peterashwoodsmith/vcheck/vcheck.pdf

+5v

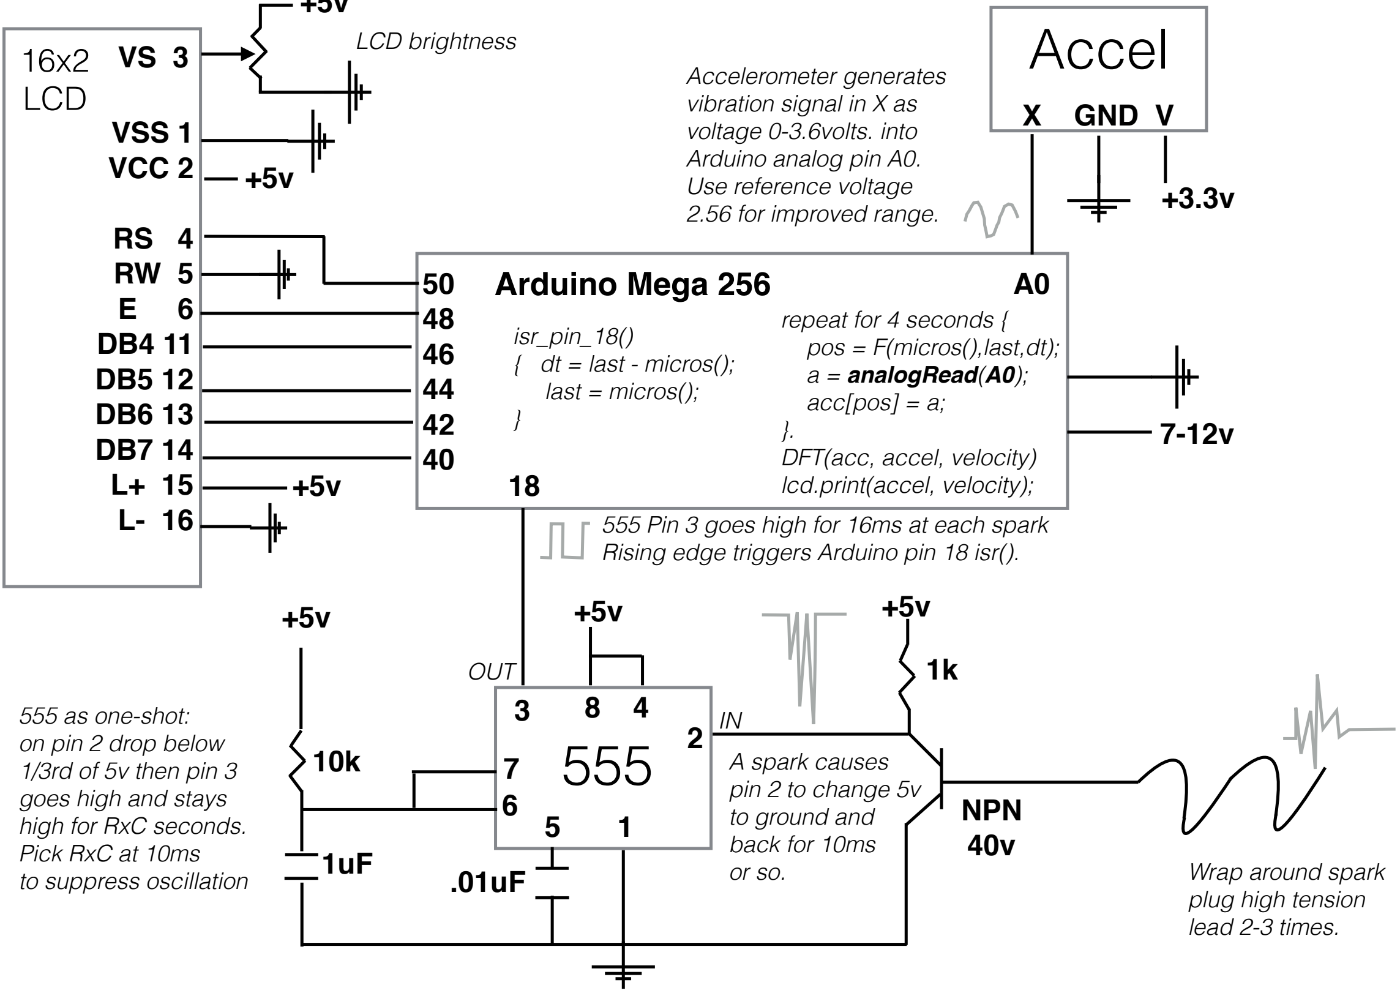
[picture p1: figure]
Arduino Mega 256; Accel; X GND V; 16x2 LCD; VSS 1 VCC 2; A spark causes pin 2 to change 5v to ground and back for 10ms or so.; 555 as one-shot: on pin 2 drop below 1/3rd of 5v then pin 3 goes high and stays high for RxC seconds. Pick RxC at 10ms to suppress oscillation; Wrap around spark plug high tension lead 2-3 times.; LCD brightness; Accelerometer generates vibration signal in X as voltage 0-3.6volts. into Arduino analog pin A0. Use reference voltage 2.56 for improved range.; repeat for 4 seconds { pos = F(micros(),last,dt); a = analogRead(A0); acc[pos] = a;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

555 Pin 3 goes high for 16ms at each spark Rising edge triggers Arduino pin 18 isr().

# V-CHECK: Arduino Engine Balancer Analyzer Design

### Bread Board Solder Side

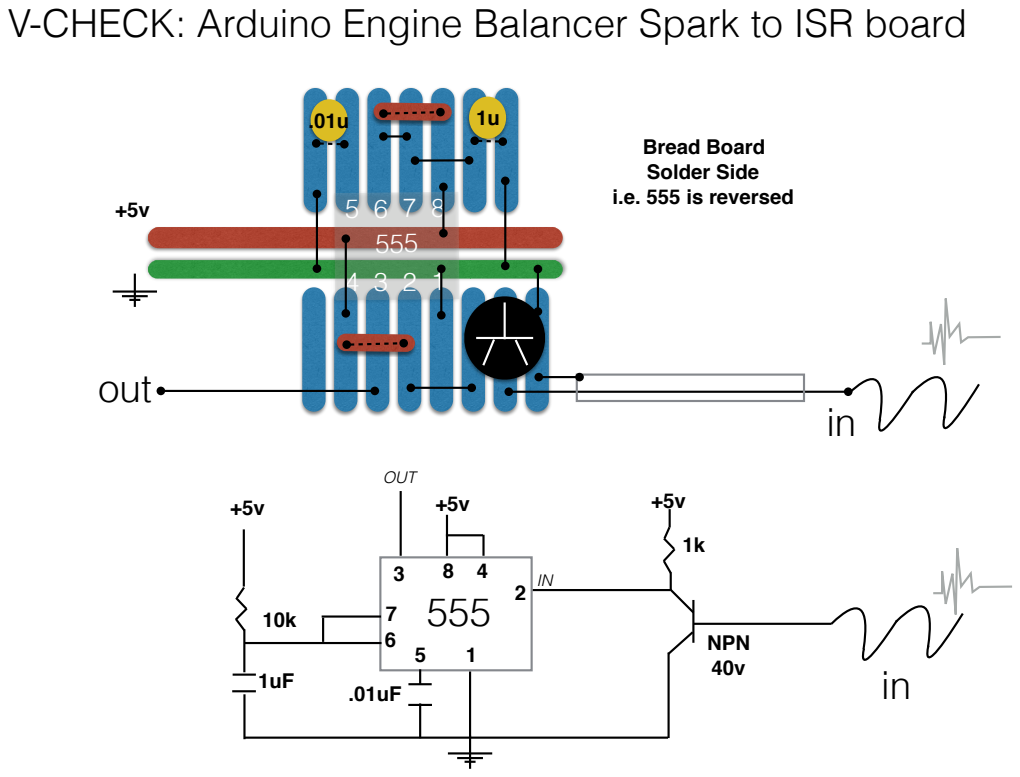
[picture p2: page 2]
i.e. 555 is reversed; OUT; out; NPN

V-CHECK: Arduino Engine Balancer Spark to ISR board
